kim6419/2020-Gesture-control/README.md

# 2020-Gesture-control

https://www.youtube.com/watch?v=y3VIeYEoiQM&t=1s





   제스처 컨트롤은 간단한 손동작으로 특정 행동을 취하도록 하는 것을 말합니다. 사진은 각각 손가락 사이에 착용하여 사용하는 컨트롤러, 제스처 모션을 인식하는 디바이스, 팔에 착용하여 근전도 센서를 이용하는 기기가 있습니다. 
   간단한 일이라도 사람이 직접 움직여야 했던 것을 간단한 손짓으로 해결할 수 있게 된다는 것은 삶의 질을 향상시키는데 크게 작용할 것 입니다.

   AR, VR을 이용한 컨텐츠는 게임뿐만 아니라, 교육, 산업 다양한 현장에 적용되고 있고, 현장의 다양한 요구사항을 적용할 수 있는 컨트롤러의 필요성이 증가하고 있다. 
   이번 캡스톤 과제에서 구현하고자 하는 ‘Advanced Gesture Controller’는 기존의 장갑형 컨트롤러의 기능을 확장하고, 
   입력에 대한 반응을 통해 보다 현실감 있는 조작 경험을 제공할 수 있는 형태로 제작할 예정이다.
