kim6419/2020-Gesture-control/Modeling/모델링 2/모델링 2-1.png

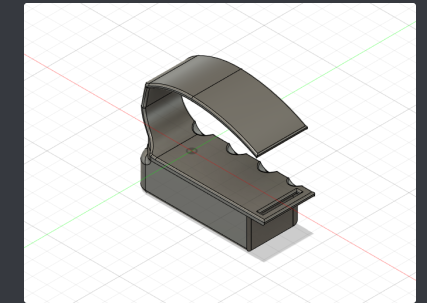
Modeling/모델링 2/모델링 2-1.png
