kim6419/2020-Gesture-control/Arduino/coding/플렉스 센서 , 자이로 센서 를 이용한 서보모터 구동 코드/flex_gyro_servo.ino

#include <Wire.h>
#include <Servo.h>

#define CTRL_REG1 0x20
#define CTRL_REG2 0x21
#define CTRL_REG3 0x22
#define CTRL_REG4 0x23
#define CTRL_REG5 0x24

int pinServo = 9;

int L3G4200D_Address = 105; //I2C address of the L3G4200D

int x;
int y;
int z;

int flexpin1 = A0;
int flexpin2 = A1;
int flexpin3 = A2;

Servo myServo;

void setup(){

Wire.begin();
 Serial.begin(9600);
 
 myServo.attach(pinServo);

Serial.println("starting up L3G4200D");
 setupL3G4200D(2000); // Configure L3G4200 - 250, 500 or 2000 deg/sec
delay(1500);
}

void loop(){

  int flexVal1;
  int flexVal2;
  int flexVal3;

  flexVal1 = analogRead(flexpin1);
  flexVal2 = analogRead(flexpin2);
  flexVal3 = analogRead(flexpin3);

 flexVal1 = map(flexVal1, 180, 290, 0, 180);
  myServo.write(flexVal1);
  delay(10);
  
 getGyroValues(); // This will update x, y, and z with new values

Serial.print("   플렉스1: ");
Serial.print(flexVal1);
Serial.print("   플렉스2: ");
Serial.print(flexVal2);
Serial.print("   플렉스3: ");
Serial.print(flexVal3);

Serial.print("   X축:");
 Serial.print(x); 
 Serial.print("  Y축:");
 Serial.print(y);
Serial.print("  Z축:");
 Serial.println(z);

if(flexVal1 >= 1000 && flexVal2 >= 800){
  myServo.write(90);

delay(100); //Just here to slow down the serial to make it more readable

}
}

void getGyroValues(){

byte xMSB = readRegister(L3G4200D_Address, 0x29);
 byte xLSB = readRegister(L3G4200D_Address, 0x28);
 x = ((xMSB << 8) | xLSB);

byte yMSB = readRegister(L3G4200D_Address, 0x2B);
 byte yLSB = readRegister(L3G4200D_Address, 0x2A);
 y = ((yMSB << 8) | yLSB);

byte zMSB = readRegister(L3G4200D_Address, 0x2D);
 byte zLSB = readRegister(L3G4200D_Address, 0x2C);
 z = ((zMSB << 8) | zLSB);
}

int setupL3G4200D(int scale){
 //From Jim Lindblom of Sparkfun's code

// Enable x, y, z and turn off power down:
 writeRegister(L3G4200D_Address, CTRL_REG1, 0b00001111);

// If you'd like to adjust/use the HPF, you can edit the line below to configure CTRL_REG2:
 writeRegister(L3G4200D_Address, CTRL_REG2, 0b00000000);

// Configure CTRL_REG3 to generate data ready interrupt on INT2
 // No interrupts used on INT1, if you'd like to configure INT1
 // or INT2 otherwise, consult the datasheet:
 writeRegister(L3G4200D_Address, CTRL_REG3, 0b00001000);

// CTRL_REG4 controls the full-scale range, among other things:

if(scale == 250){
 writeRegister(L3G4200D_Address, CTRL_REG4, 0b00000000);
 }else if(scale == 500){
 writeRegister(L3G4200D_Address, CTRL_REG4, 0b00010000);
 }else{
 writeRegister(L3G4200D_Address, CTRL_REG4, 0b00110000);
 }

// CTRL_REG5 controls high-pass filtering of outputs, use it
 // if you'd like:
 writeRegister(L3G4200D_Address, CTRL_REG5, 0b00000000);
}

void writeRegister(int deviceAddress, byte address, byte val) {
 Wire.beginTransmission(deviceAddress); // start transmission to device 
 Wire.write(address); // send register address
 Wire.write(val); // send value to write
 Wire.endTransmission(); // end transmission
}

int readRegister(int deviceAddress, byte address){

int v;
 Wire.beginTransmission(deviceAddress);
 Wire.write(address); // register to read
 Wire.endTransmission();

Wire.requestFrom(deviceAddress, 1); // read a byte

while(!Wire.available()) {
 // waiting
 }

v = Wire.read();
 return v;
}
